johannes-jansson/coffee-proclaimer/(threads)

Thread 10 (2020-02-18):

Add a server

johannes-jansson, 2020-02-18:
In order to take the coffee-proclaimer to the next level, we should add a server. This would allow us to:

- Store historical data to a database
- Create a true slack integration, not just incoming webhooks
- Write slack stuff in a more convenient language than C++.

This is a large project, but there ain't no mountain high enough to keep us from a superb coffee experience ☕️ 👌
