johannes-jansson/coffee-proclaimer/src/app.ino

#include "math.h"
#include "./src/coffee-messages.h"
#define READ_PIN A5
#define GROUND_PIN A4
#define LED_PIN D7

#define NBR_OF_READINGS 500
#define READING_DELAY 1
#define LOOP_DELAY 2000

#define UPPER_TRESHOLD 1000
#define MIDDLE_TRESHOLD 200
#define LOWER_TRESHOLD 30

#define K1 0.03650164
#define M1 -0.49918924
#define K2 11.6600
#define M2 34

#define AUTO_TURNOFF_TIME 29 * 60 * 1000

SYSTEM_MODE(SEMI_AUTOMATIC);

int state = 0;
int positiveReadings[NBR_OF_READINGS];
unsigned long timer;
unsigned long boilerTimer;
int elapsed;
float cups = -1;
int nbrOfCups = 0;
int dripDelay = 0;
int maxRandomNumber = 100;
Coffeemessages msgs;

void setup() {
  pinMode(READ_PIN, INPUT);
  pinMode(GROUND_PIN, INPUT);
  pinMode(LED_PIN, OUTPUT);
  digitalWrite(LED_PIN, LOW);
  WiFi.on();
  WiFi.connect();
  Particle.connect();
  Particle.function("setState", setState);
  Particle.function("getCups", getCups);
  Particle.function("setCups", setCups);
}

void loop() {
  int reading = readMany("");

  // check if boiling has started
  if (state == 0 && reading > UPPER_TRESHOLD) {
    state = 1;
    timer = millis();
    started();
    return;
  }

  // check if boiling has finished and heating has started
  if (state == 1 && reading < MIDDLE_TRESHOLD && reading > LOWER_TRESHOLD) {
    state = 2;
    boilerTimer = millis();
    Particle.publish("tsBoilTimer", String(boilerTimer - timer), PUBLIC);
    cups = K1 * (boilerTimer - timer) / 1000.0 + M1;
    dripDelay = (K2 * cups + M2) * 1000;
    return;
  }

  // check if the coffee is ready (based on time since boiler done)
  if (
    state == 2 &&
    reading < MIDDLE_TRESHOLD && reading > LOWER_TRESHOLD &&
    millis() - boilerTimer > dripDelay
  ) {
    state = 3;
    done();
  }

  // check if heat pad is turned off
  if (state != 0 && reading < LOWER_TRESHOLD) {
    state = 0;
    elapsed = millis() - timer;
    finished(elapsed);
    return;
  }

  // Make sure we have wifi connection
  if (!Particle.connected()) Particle.connect();
  if (!WiFi.ready()) {
    WiFi.on();
    WiFi.connect();
  }

  // If it's 3 AM and the device has been running for more than two hours (one wasn't enough)
  if (Time.hour() == 3 && millis() > 2 * 60 * 60 * 1000) {
    Particle.publish("dev_slack", Time.timeStr() + ", I'm resetting", PUBLIC);
    System.reset();
  }

  delay(LOOP_DELAY);
}

// Do NBR_OF_READINGS readings, return RMS value 🔬
int readMany(String command) {
  digitalWrite(LED_PIN, HIGH);

  // make reads as ints and store them away because it's fast ⚡️
  // subtract virtual ground to keep things smooth and accurate 😎
  for (int i = 0; i < NBR_OF_READINGS; i++) {
    positiveReadings[i] = analogRead(READ_PIN) - analogRead(GROUND_PIN);
    delay(READING_DELAY);
  }

  // Calculate root mean squared value 📈
  float sumSquared = 0;
  for (int i = 0; i < NBR_OF_READINGS; i++) {
    sumSquared = sumSquared + pow(positiveReadings[i], 2);
  }

  // cast it as an int because it's convenient to handle in the particle cloud,
  // and because it feels cheesy to store int readings in a float just because
  // we did some fancy math on it 🧀
  int rms = sqrt(sumSquared / NBR_OF_READINGS);

  digitalWrite(LED_PIN, LOW);
  return rms;
}

/* cloud functions -------------------- */

int setState(String newState) {
  state = newState.toInt();
  return state;
}

int getCups(String s) {
  return nbrOfCups;
}

int setCups(String newCups) {
  nbrOfCups = newCups.toInt();
  return nbrOfCups;
}

/* event handlers -------------------- */

void started() {
  bool first = nbrOfCups == 0;
  String outstring = "";
  if (Time.hour() < 10 && first) outstring += "Good morning!\n";
  outstring += "Coffee is on it's way! Sit tight! :rocket:";

  msgs.proclaim(outstring);
  return;
}

void done() {
  bool firstCupsOfTheDay = nbrOfCups == 0;
  int freshCups = (int) round(cups);
  nbrOfCups += freshCups;
  // The following line publishes number of cups to our data api
  Particle.publish("cups", String(freshCups), PUBLIC);

  String coffeeDoneMessage = coffeeDoneMessageCompiler(firstCupsOfTheDay, nbrOfCups, freshCups);

  msgs.proclaim(coffeeDoneMessage);
  return;
}

String coffeeDoneMessageCompiler(bool firstCupsOfTheDay, int totalNumberOfCups, int servedCups) {
  return coffeeDoneNumberOfCupsServedCompiler(servedCups) + coffeeDoneStatisticsMessageCompiler(totalNumberOfCups,firstCupsOfTheDay);
}

String coffeeDoneNumberOfCupsServedCompiler(int servedCups) {
  String optionalMessage = "";

  if (random(maxRandomNumber) == maxRandomNumber) {
    optionalMessage = "EXTERMINAT... \n FORCE SYSTEM REBOOT... \n... \n";
  }

  return optionalMessage + String((int) round(servedCups)) + " cups of coffee served! " + coffeeDoneNumberOfCupsServedExtraMessage(servedCups);
}

String coffeeDoneNumberOfCupsServedExtraMessage(int servedCups) {
  String randomEmoji;

  if (servedCups > 4) {
    randomEmoji = positiveExtraMessage() + positiveRandomEmoji();
  } else {
    randomEmoji = questioningExtraMessage() + questioningRandomEmoji();
  }

  return randomEmoji;
}

String positiveExtraMessage() {
  String positiveExtraMessage;

  int r = random(maxRandomNumber);
  if (r == 0) positiveExtraMessage = "Coffee 'o clock y'all! '";
  else positiveExtraMessage = "Everything is coming together ";

  return positiveExtraMessage;
}

String positiveRandomEmoji() {
  String positiveRandomEmoji;

  int r = random(20);
  if (Time.weekday() == 6) positiveRandomEmoji = ":coffee_parrot:";
  else if (r == 0) positiveRandomEmoji = ":aw_yeah:";
  else if (r == 1) positiveRandomEmoji = ":carlton:";
  else if (r == 2) positiveRandomEmoji = ":thumbsup_all:";
  else if (r == 3) positiveRandomEmoji = ":the_horns:";
  else if (r == 4) positiveRandomEmoji = ":raised_hands:";
  else if (r == 5) positiveRandomEmoji = ":aw_yeah:";
  else if (r == 6) positiveRandomEmoji = ":carlton:";
  else if (r == 7) positiveRandomEmoji = ":parrot:";
  else if (r == 8) positiveRandomEmoji = ":star-struck:";
  else if (r == 9) positiveRandomEmoji = ":blue_heart:";
  else positiveRandomEmoji = ":coffee:";

  return positiveRandomEmoji;
}

String questioningExtraMessage() {
  String questioningExtraMessage;

  if (Time.weekday() == 6) questioningExtraMessage = "Good that the weekend is near ";
  else questioningExtraMessage = "Quick, get to the coffee machine! ";

  return questioningExtraMessage;
}

String questioningRandomEmoji() {
  String questioningRandomEmoji;

  int r = random(20);
  if (Time.weekday() == 6) questioningRandomEmoji = ":persevere:";
  else if (r == 0) questioningRandomEmoji = ":white_frowning_face:";
  else if (r == 1) questioningRandomEmoji = ":face_with_rolling_eyes:";
  else if (r == 2) questioningRandomEmoji = ":cry:";
  else if (r == 3) questioningRandomEmoji = ":sweat:";
  else if (r == 4) questioningRandomEmoji = ":tired_face:";
  else if (r == 5) questioningRandomEmoji = ":unamused:";
  else if (r == 6) questioningRandomEmoji = ":confused:";
  else if (r == 7) questioningRandomEmoji = ":worried:";
  else if (r == 8) questioningRandomEmoji = ":open_mouth:";
  else if (r == 9) questioningRandomEmoji = ":face_with_monocle:";
  else questioningRandomEmoji = ":sleeping:";

  return questioningRandomEmoji;
}

String coffeeDoneStatisticsMessageCompiler(int totalNumberOfCups, bool firstCupsOfTheDay) {
  String extraMessage = "\nThat's " + String(totalNumberOfCups) + " in total today.";

  // Optional comment based on coffee amount
  if (totalNumberOfCups > 60 && random(2) == 0) {
    extraMessage += " Pretty impressive!";
  } else if (totalNumberOfCups < 21 && !firstCupsOfTheDay && Time.hour() > 10 && random(2) == 0) {
    extraMessage += " Those are rookie numbers!";
  }

  return extraMessage;
}

void finished(int elapsed) {
  if (elapsed >= AUTO_TURNOFF_TIME) {
    msgs.proclaim("The coffee is getting cold, hurry! :snowflake:");
  } else {
    msgs.proclaim("No more coffee :frowning:");
  }
  return;
}
