johannes-jansson/coffee-proclaimer/src/coffee-messages.cpp

#include "coffee-messages.h"

Coffeemessages::Coffeemessages() {
}

void Coffeemessages::proclaim(String message) {
    Particle.publish("slack", message, PUBLIC);
}

// Example private method
void Coffeemessages::secret() {
    Serial.println("called doit");
}
