johannes-jansson/coffee-proclaimer/(commit log)

2020-01-15 Add resistor math to readme :alembic:
2020-01-17 Change how readings are made. Also cleanup
    I realized the current probe actually outputs AC current (duh). Changed
    the hardware to include virtual ground. Following software changes:
    * Readings are now made as the difference between READ_PIN and
    GROUND_PIN, the virtual ground.
    * Readings are stored as ints in an array for fast reading.
    * RMS is then calculated for the ints in this array.
2020-01-17 Add maxReading, for resistor tuning purposes
    maxReading, readable from the cloud as `max`, keeps track on the highest
    read value since startup. This should be close to, but not too close to,
    5000. If it's too far away the resistor value should be tweaked.
    [app.ino]
2020-01-17 Add heat pad timeout timer, remove cloud functions
2020-01-20 Bugfix with no more coffee :bug:
    [app.ino]
2020-01-21 Add more timers :sparkles:
    * Add timer for time from start to end of boiling
    * Add timer for time from start to turnoff of plate
    * Both timers publish to thingspeak, and will be used later for timing
2020-01-21 Restructure the code to handle timers better
2020-01-21 Remove max function, resistor is ok :ok_hand:
2020-01-27 Cup predictor fixes :bug:
    [app.ino]
2020-01-30 Reset device at 3 AM every night
    In order to avoid millis() overflowing
    [app.ino]
2020-01-30 Add cup counter :sparkles:
    Counts number of cups per day (since the device is reset every night)
    Also renamed boilerTimer to be consistent camelCase
    [app.ino]
2020-01-30 nbrOfCups improvements
    * Add setCups method, to set a cups starting value after reset
    * Remove unneccessary timer publish
    * Actually publish nbrOfCups information
    [app.ino]
2020-02-05 Connect dripdown timer model ⏲
2020-02-05 Make slack messages more dynamic!
    Also, add debug print on device restart every night to make sure it
    really happens.
2020-02-06 Re-enable semi automatic mode
    The device has suddenly started to go offline a lot more. Re-enabling
    semi automatic mode, to have better control of the reconnect attempts.
2020-02-06 Add contribution section to readme 📝
2020-02-10 fix review comments and updated emoji frequencies
    [app.ino]
2020-02-10 fix missing argument types
    [app.ino]
2020-02-10 fix issue with double spaces and missing capitalizations
    [app.ino]
2020-02-11 Move app.ino to src directory ➡️
2020-02-11 Add coffee-messages "library"
    Just some sample functions for now to test. Will move all slack string
    generation here later on
2020-02-16 Fix name of star-struck emoji
    Closes #8
    [app.ino]
2020-02-16 Fix rounding issue
    Closes #5
    [app.ino]
2020-02-21 Increase timer for resetting at night
    The device has been resetting multiple times some night. Hopefully closes #11
    [app.ino]
